maciejleszek/tupek-case/README.md

# tupek-case
Repository of school internship project: Design and creation on a 3D printer of a protective case for STM32-E407 board controlling Wild Thumper 6WD robot
