maciejleszek/tupek-case/Texts/plan dniowy.md

#### Dzienny harmonogram wykonnanych czynności
- 04.05 - wtorek: Utworzenie repozytorium na GitLabie; utworzenie projektu w Vue; podpięcie projektu pod repozytorium; nadanie uprawnień; rozplanowanie aplikacji - interfejs, zasada działania, wstępne problemy;
- 05.05 - środa: Mail z informacjami, zaznajamianie się z dokumentacją Google Maps - Google Cloud Platform, Google Maps Platform, Google Maps API, zapoznanie się z mapami OpenStreetMap;
- 06.05 - czwartek: szukanie informacji, dokumentacji przykładów dotyczących OpenStreetMap, zapoznanie się z dokumentacją developerską OpenStreetMap, analiza OpenRouteService i jej dokumentacji, analiza MyMaps, analiza OpenSourceRoutingMachine; 
- 07.05 - piątek: analiza czym mógłbym się zająć, podjęcie decyzji, że najlepiej się zająć AutoCadem - powtórki 2d, początki z 3d;
- 10.05 - poniedziałek: spotkania Teams, decyzja o wykonaniu zadania na bazie modelowania 3D, wybór programu - Inventor, pobranie i zapoznanie się z programem, wykonanie pierwszych ćwiczeń dostępnych od Autodesk, wstępny rysunek obudowy, mail z pytaniami;
- 11.05 - wtorek: kolejne ćwiczenia w programie Inventor od Autodesk, przerobienie wszystkich ćwiczeń z typu Szybki Start, analiza filmów wideo możliwości podwozia robota, ćwiczenia z typu Podstawowy, analiza konstrukcji do przedstawienia jutro;
- 12.05 - środa: wizyta w Instytucie, poznanie zespołu, zapoznanie się z platformą robota, halą, drukarką 3D, wykonanie pomiarów, zdjęć i szkicy, dyskutowanie o możliwościach i pomysłach wykonania obudowy;
- 13.05 - czwartek: analiza notatek, wymagań i zamieszczenie ich w pliku README.md w celu upewnienia się, że dokładnie je zrozumiałem; szukanie informacji o płytce STM32 - model 3d, szkice, wymiary; szukanie informacji o szynie Picattiny oraz pasującym do niej zaczepie - model 3d, wymiary; analiza możliwości drukarki 3D, tworzenie pierwszych części płytki w Inventorze;
- 14.05 - piątek: kontynuacja modelowania pierwszego konceptu, wstępne wykonanie pierwszego modelu spełniającego wymagania i funkcje
- 17.05 - poniedziałek: poprawki do modelu 3D, wykonanie prezentacji z analizą konceptu obudowy
- 18.05 - wtorek: poprawki w prezentacji, wizyta w Instytucie, dyskusja o prezentacji, wykonanie kolejnych pomiarów i dalszego planu pracy poprawek
- 19.05 - środa: wykonanie: opisu wymagań, analizy wymagań, analizy sposobu montażu obudowy do podwozia
- 20.05 - czwartek: dalsza analiza sposobu montażu obudowy podwozia, szukanie rozwiązań mocowania górnej części obudowy, analiza dostępnych w internecie projektów obudów na moduły Arduino i Raspberry Pi, mail z wykonaną pracą
- 21.05 - piątek: analiza rozwiązań górnej części obudowy, dalsze szukanie rozwiązań wśród firm produkujących obudowy do Arduino 
i Raspberry Pi, zebranie informacji o nich w tabeli Excel, wysłanie maili, wysłanie maila z podsumowaniem
- 24.05 - poniedziałek: analiza książek dot. druku 3D dostępnych w bibiotece PW, rezerwacja wybranych pozycji do wglądu na miejscu, analiza osób z PW zajmujących się drukiem 3D, napisanie wiadomości email do tych osób, wstępna analiza mocowań anteny, wstępnie wykonany opis gotowych pomysłów montażu górnej i dolnej cz. obudowy
- 25.05 - wtorek: analiza książek w Bibliotece PW, analiza sugestii pracowników PW, dokończenie opisu pomysłów na montaż górnej i dolnej cz. płytki oraz na montaż anteny
- 26.05 - środa: dokończenie materiałów do prezentacji, prezentacja pomysłów i zebranych materiałów, podjęcie decyzji, które pomysły są najlepsze, rozpoczęcie dokładnych szkiców i projektowania, wykonanie próbnego elementu platformy, zapoznanie się z normami śrub i insertów
- 27.05 - czwartek: poprawki do modelu próbnego, dalsze projektowanie obudowy, wizyta w Instytucie, wykonanie kolejnych pomiarów, wstępne ukończenie projektowania obu części obudowy
- 28.05 - piątek: kontynuacja projektowania, wizyta w Instytucie - kolejne pomiary, testy wydrukowanej platformy, dyskusja, ukończenie całego projektu
- 31.05(02.06) - poniedziałek: wypisanie dzienniczka praktyk, wizyta w Instytucie, rozmowa o praktykach, wypełnienie formalności
