maciejleszek/tupek-case/Texts/wymagania.md

#### Wymagania

**Funkcje**

1 Osłona części elektronicznych i okablowania znajdujących się na czerwonej płytce - STM32-E407;

2 Prosty demontaż obudowy z podwozia robota;

3 Umiejscowienie anteny, by obudowa nie zakłócała emisji fal magnetycznych;

4 W miarę możliwości wykorzystanie, w jak największym stopniu, dostępnych elementów oraz drukarki 3D – Prusa i3 mk3;

**Wymagania**

5 Zaprojektowanie osłony czerwonej płytki, aby spełniała powyższe funkcje;

6 Analiza różnych konspektów i wybranie jednego rozwiązania – argumentując (plusy i minusy);

7 Wybór sposobu mocowania osłony do podwozia – argumentując (plusy i minusy);

#### Rozwinięcie

##### **1 Osłona części elektronicznych i okablowania znajdujących się na czerwonej płytce - STM32-E407:** 

1.	Zapewnienie potrzebnych luzów na przewody, elementy elektroniczne, dolne miejsca lutowania – wykonanie dokładnych pomiarów
2.	Sposób wyprowadzenia przewodów z obudowy – zaproponowanie lokalizacji
3.	Wodo i pyłoszczelność – zamknięta konstrukcja, odpowiedni sposób montażu, uszczelki - przeanalizowac i wybrać stopień ochrony
4.	Estetyka – nie w sprzeczności z praktycznością i prostym demontażem
5.	Prosta konstrukcja – drukowalna, ułatwiająca demontaż
6.	Ew. praktyczność zastosowania górnej części obudowy – możliwość montażu kolejnych elementów

##### **2 Prosty i szybki montaż i demontaż obudowy na podwoziu robota:** 
1.	Szybki sposób – najlepiej niewymagający użycia narzędzi
2.	Sposób mocowania niezajmujący niepotrzebnego miejsca na podwoziu
3.	Możliwość montażu w dowolnym miejscu na górnej części podwozia – brak konieczności montażu obudowy przed innymi elementami robota 
4.	Kompatybilność z dostępnymi możliwościami – szyna Picatinny oraz otwory w podwoziu
5.	Przewidzieć sposób montażu i demontażu – wytrzymałość i wykonalność
6.	Przewidzieć miejsce na ew. klucze

#####  **3 Prosty montaż i demontaż górnej części pokrywy – dostęp do płytki:** 
1.	Zastosowanie wielorazowego i mocnego sposobu montażu – (np. śruby)
2.	Ewentualna możliwość dostępu do płytki, bez konieczności demontażu obudowy z podwozia – górna część pokrywy jest mocowana oddzielnie, nie całość (cz1, cz2, mocowanie do podwozia) razem 
3.	Estetyczny wygląd sposobu mocowania od góry
4.	Zastosowanie szyn ułatwiających spasowanie dwóch części
5.	Przewidzieć sposób demontażu – wykonalny (np. blokada nakrętek – nie mogą się same kręcić)

##### **4 Umiejscowienie anteny, by obudowa nie zakłócała emisji fal magnetycznych:** 
1.	Antena musi być skierowana do góry – pionowo, poziomo
2.	Antena nie może się poruszać w środku obudowy – może zostać uszkodzona przez wibracje
3.	Estetyka wykonania – najlepiej, żeby osłona anteny była schowana w środku obudowy, nie jako dodatkowy element na zewnątrz

##### **5 W miarę możliwości wykorzystanie, w jak największym stopniu, dostępnych elementów oraz   drukarki 3D – Prusa i3 mk3:** 
1.	Zaprojektowanie elementów, które da się wydrukować na dostępnej drukarce Prusa i3 mk3 – brak możliwości druku w powietrzu (ew. pomijając druk otworów)
2.	Zaprojektowanie otworów pod dostępne śruby
3.	Zaprojektowanie otworu na przewody pod dostępny przepust
4.	Zaprojektowanie tych elementów, które są podobne do dostępnych z tymi samymi/podobnymi wymiarami (np. zaczepy do szyny)
