maciejleszek/tupek-case/3D models/The lower part of the aerial protection element.stl

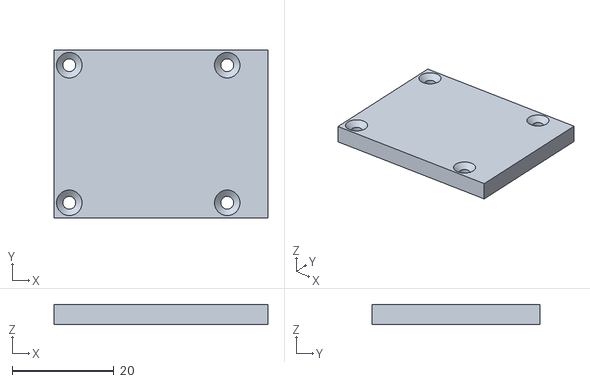
[picture p31: CAD file, 2022-09-13]
3D models/The lower part of the aerial protection element.stl
42.0 x 33.0 x 4.00
