maciejleszek/tupek-case/3D models/The upper part of the case with an element for aerial protection.stl

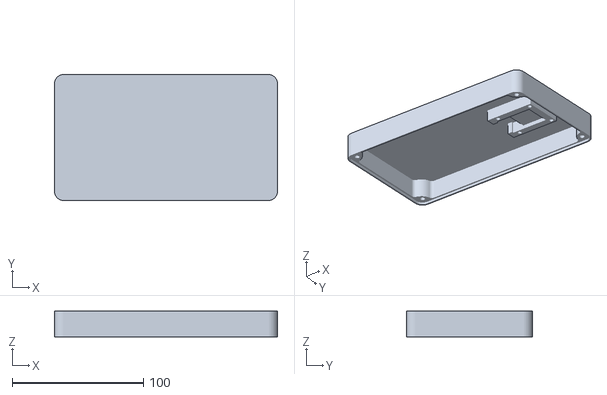
[picture p32: CAD file, 2022-09-13]
3D models/The upper part of the case with an element for aerial protection.stl
170.0 x 96.0 x 19.5
