maciejleszek/tupek-case/3D models/The bottom part of the case.stl

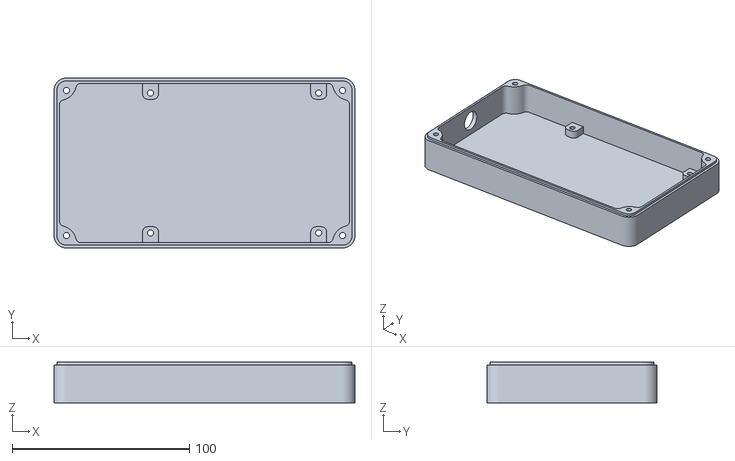
[picture p33: CAD file, 2022-09-13]
3D models/The bottom part of the case.stl
170.0 x 96.0 x 23.0
