maciejleszek/tupek-case/3D models/The upper part of the aerial protection element.stl

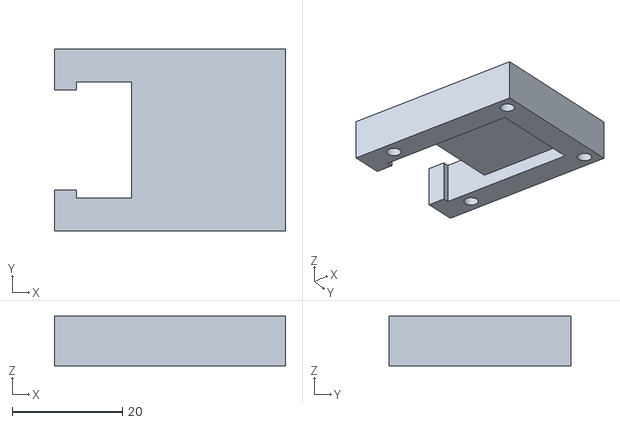
[picture p34: CAD file, 2022-09-13]
3D models/The upper part of the aerial protection element.stl
42.0 x 33.0 x 9.00
