maciejleszek/tupek-case/3D models/Platform.stl

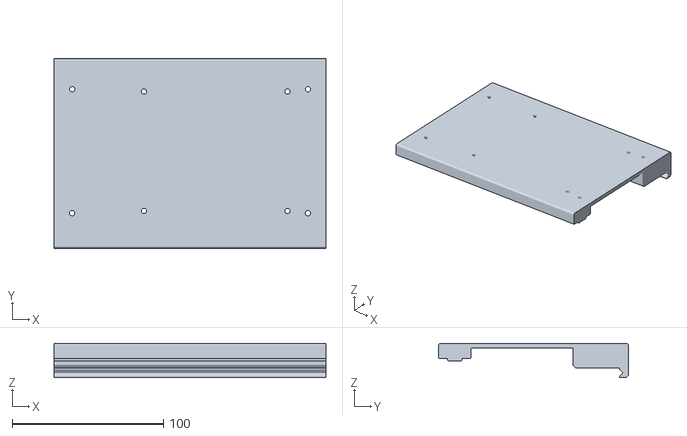
[picture p35: CAD file, 2022-09-13]
3D models/Platform.stl
180.0 x 125.8 x 22.5
