maciejleszek/tupek-case/(commit log)

2022-09-13 Creating a folder for 3D prints
2022-09-13 Commiting 3D prints to the folder
    [Platform.stl, The bottom part of the case.stl, The lower part of the aerial protection element.stl, The upper part of the aerial protection element.stl, The upper part of the case with an element for aerial protection.stl]
2022-09-13 Commiting text files - all in Polish!
    [Companies producing protection cases.xlsx]
2022-09-13 3D models are saved in STL
